SensorsUnleashed/relayboard/output/Drill file generation.png

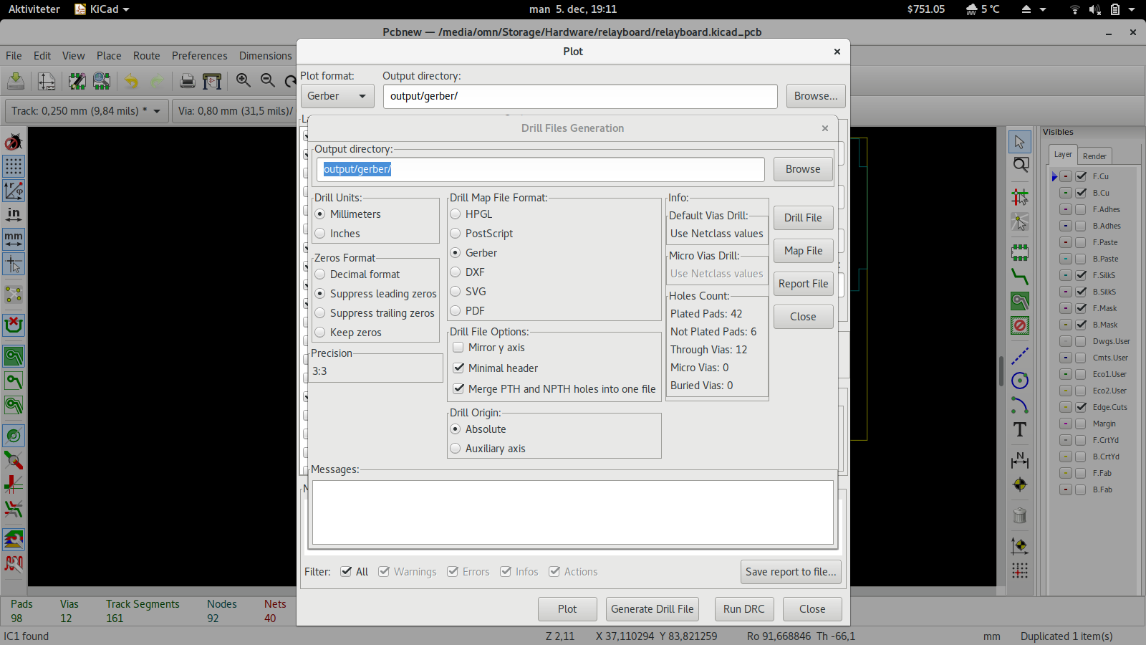
output/Drill file generation.png
