SensorsUnleashed/relayboard/output/Gerber generation.png

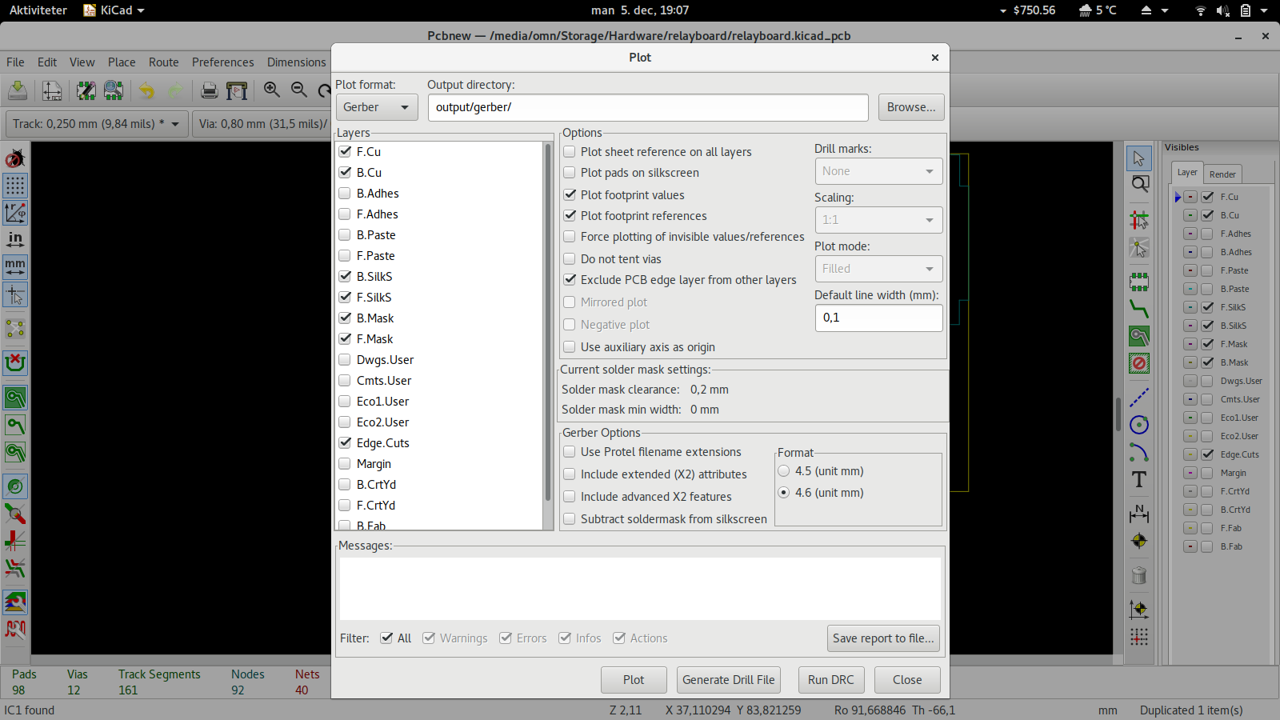
output/Gerber generation.png
