SensorsUnleashed/relayboard/output/schematic.pdf

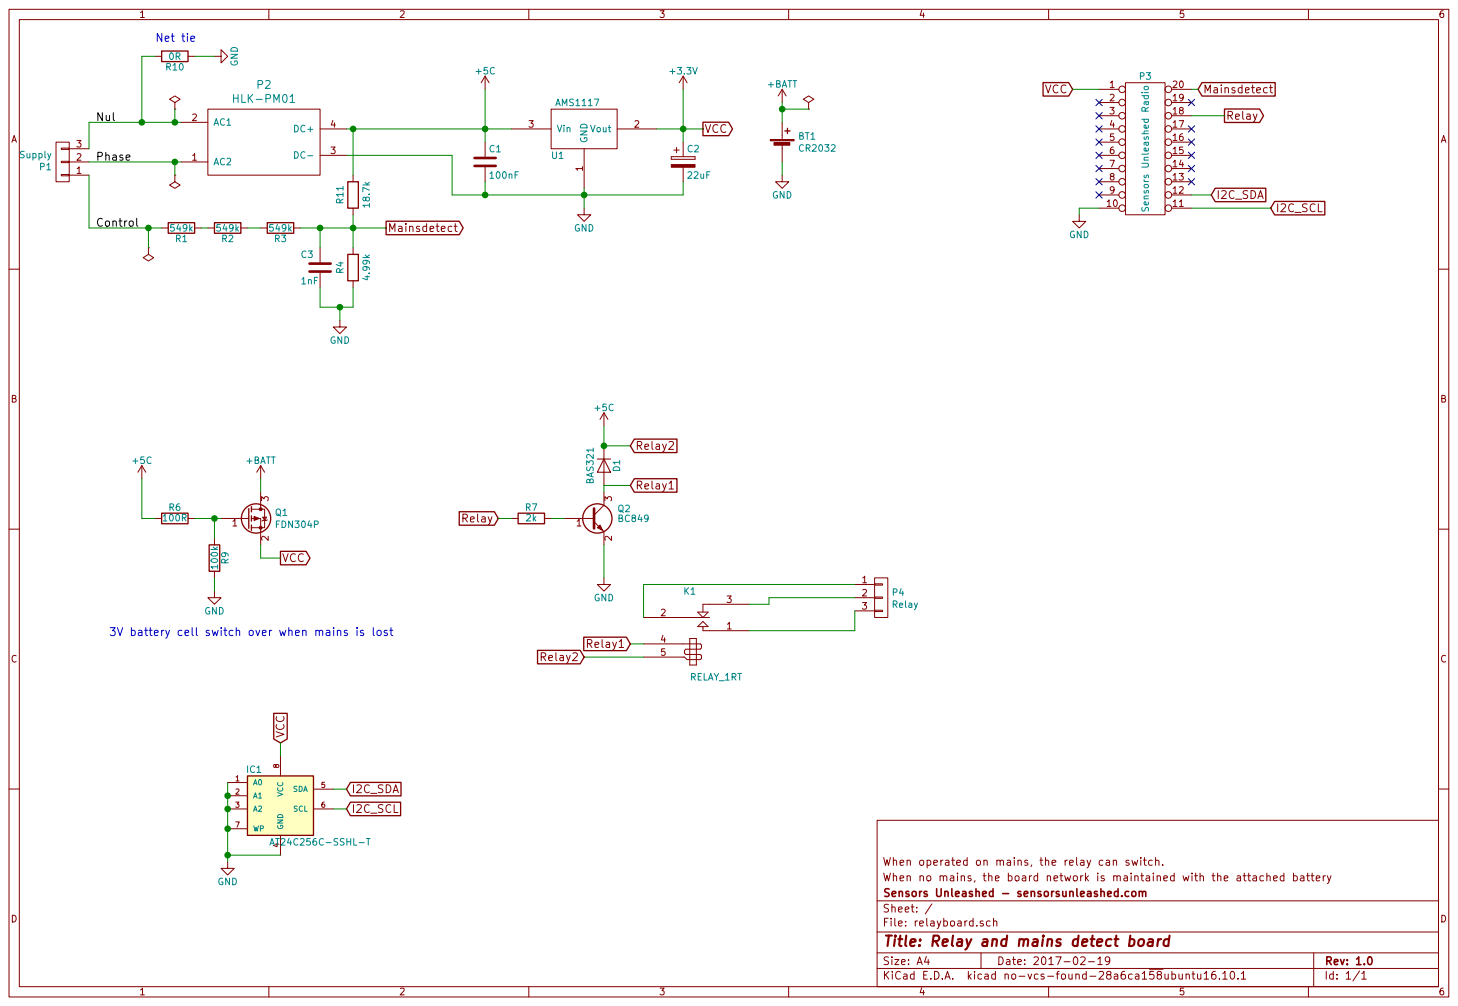
[picture p11: page 1]

3V battery cell switch over when mains is lost

4 SDA 5 SCL 6 WP 7 VCC

When operated on mains, the relay can switch.
File: relayboard.sch Sheet: / Sensors Unleashed - sensorsunleashed.com When no mains, the board network is maintained with the attached battery

Id: 1/1 Title: Relay and mains detect board
