SensorsUnleashed/relayboard/relayboard.kicad_pcb

## KiCad design relayboard.kicad_pcb (2017-03-07)

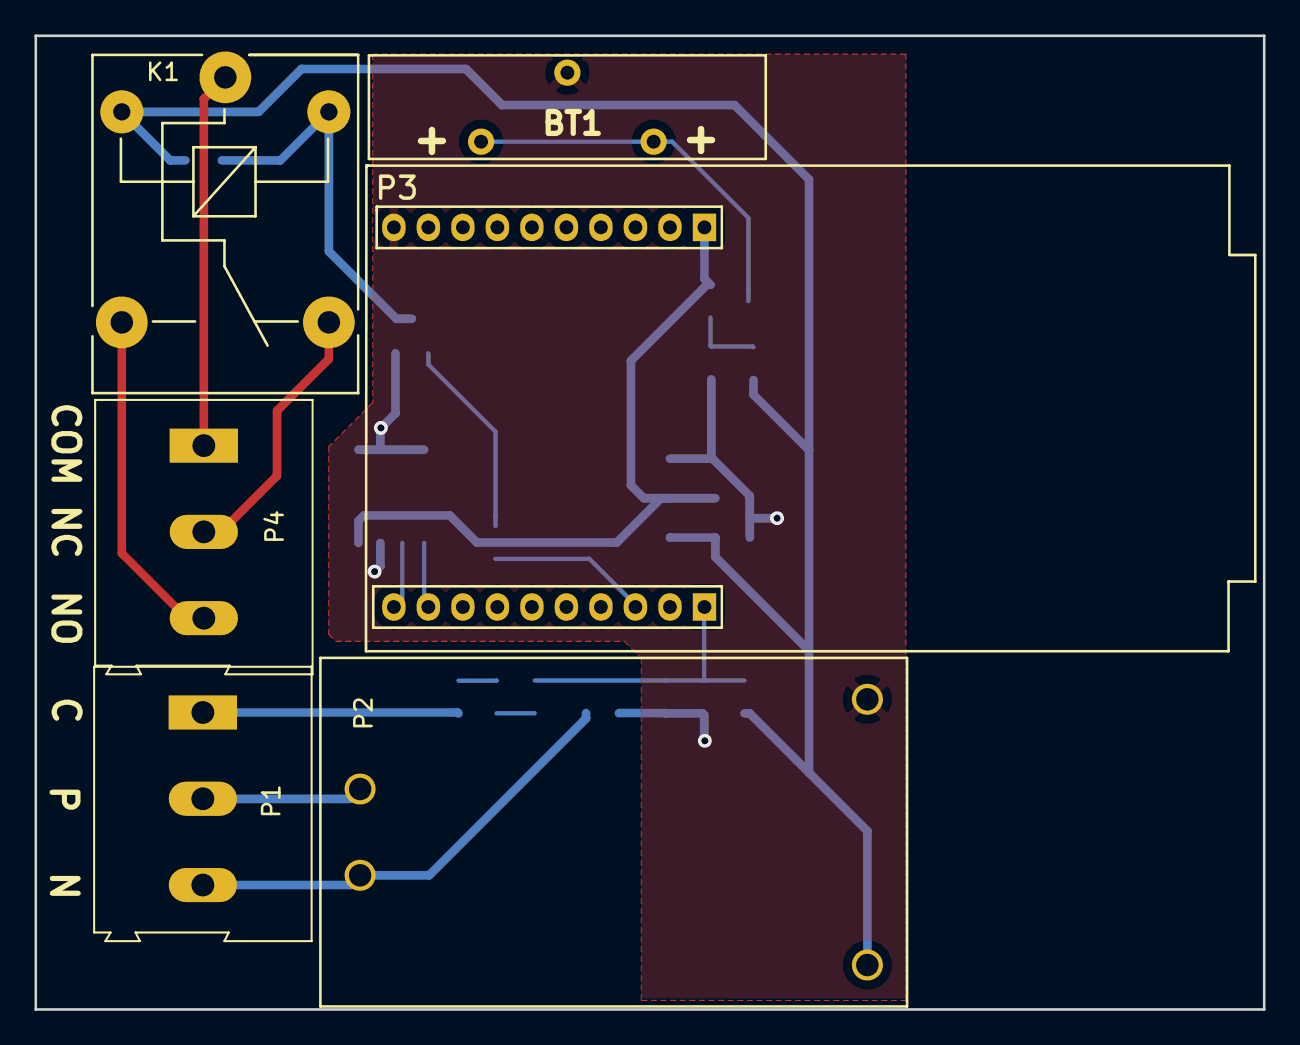
[picture p12: board relayboard.kicad_pcb from above]

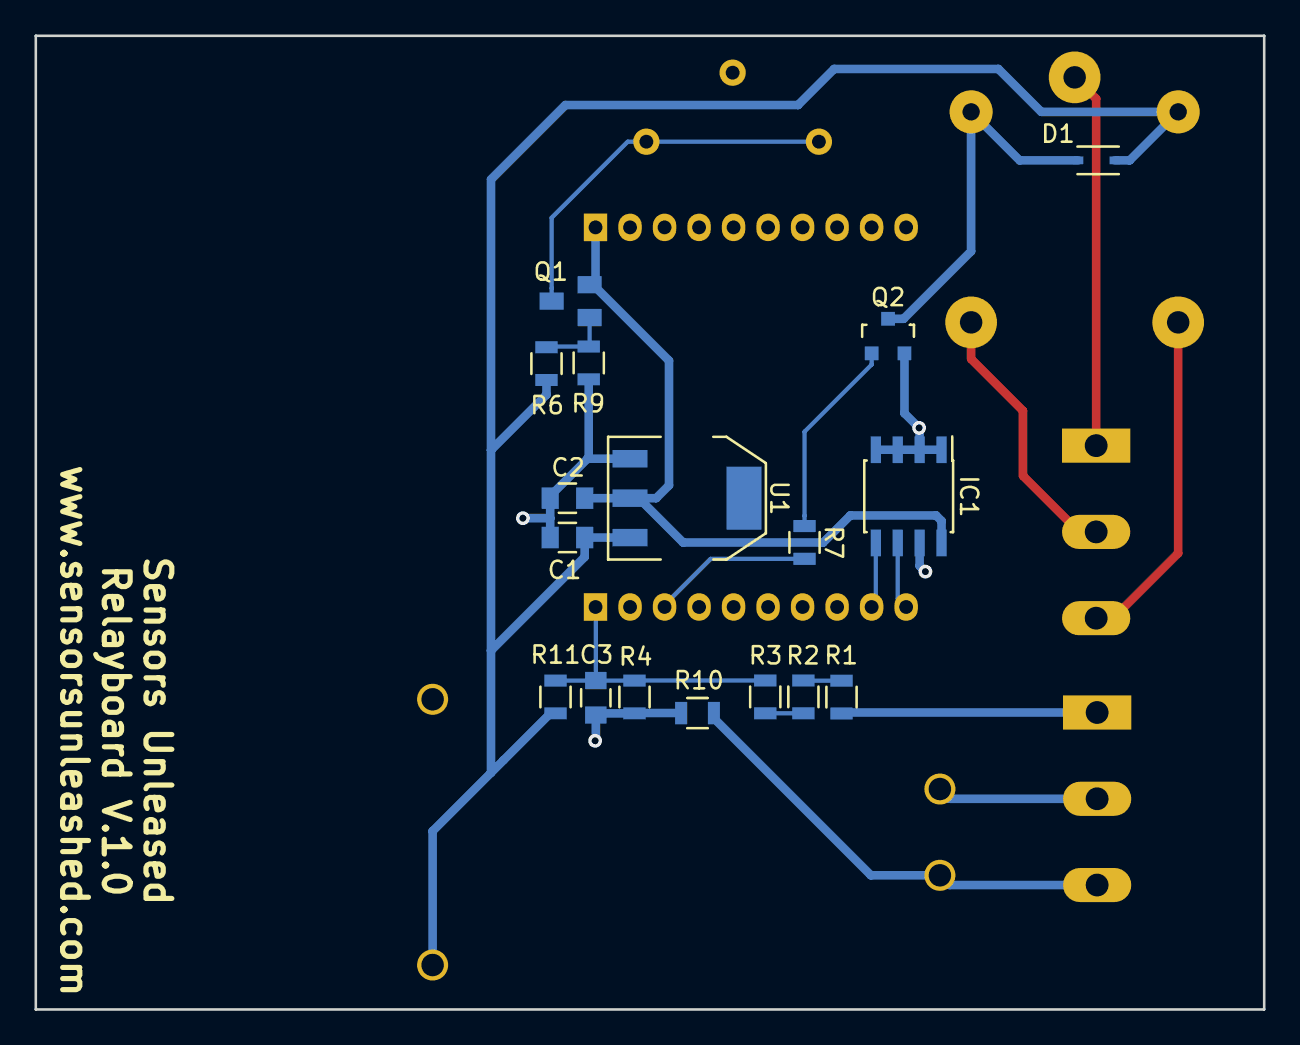
[picture p13: board relayboard.kicad_pcb from below]

Board: 2 copper layers, 71.2 x 56.4 mm, 23 parts (17 on the bottom side), 19 nets.

Parts:
BT1: CR2032; BATT_CR2032_VERT
C1: 100nF; C_0805
C2: 22uF; C_0805
C3: 1nF; C_0805
D1: BAS321; SOD-323
IC1: AT24C256C-SSHL-T; SOIC-8_3.9x4.9mm_Pitch1.27mm
K1: RELAY_1RT; Relay_SRD_XVDC-SL-C_Series
P1: Supply; AK300-3
P2: HLK-PM01
P3: Sensors Unleashed Radio; zb3219PA_radio
P4: Relay; AK300-3
Q1: FDN304P; SSOT-3
Q2: BC849; SOT-23
R1, R2, R3: 330k; R_0805
R4: 6040R; R_0805
R6: 100R; R_0805
R7: 2k; R_0805
R9: 100k; R_0805
R10: 0R; R_0805
R11: 12835R; R_0805
U1: AMS1117; SOT-223

Connections:
+BATT: BT1.1, Q1.3
/Control: P1.1, R1.2
/Nul: P1.3, P2.2, R10.2
/Phase: P1.2, P2.1
GND: BT1.2, C1.2, C2.2, C3.2, IC1.1, IC1.2, IC1.3, IC1.4, IC1.7, P2.3, P3.10, Q2.2, R4.2, R9.2, R10.1, U1.1
I2C_SCL: IC1.6, P3.11
I2C_SDA: IC1.5, P3.12
Mainsdetect: C3.1, P3.20, R3.1, R4.1, R11.2
unnamed: K1.1, P4.3
unnamed: K1.2, P4.1
unnamed: K1.3, P4.2
unnamed: Q1.1, R6.2, R9.1
unnamed: Q2.1, R7.2
unnamed: R1.1, R2.2
unnamed: R2.1, R3.2
Relay: P3.18, R7.1
Relay1: D1.2, K1.4, Q2.3
Relay2: C1.1, D1.1, K1.5, P2.4, R6.1, R11.1, U1.3
VCC: C2.1, IC1.8, P3.1, Q1.2, U1.2
