SensorsUnleashed/relayboard/(commit log)

2017-03-07 First prototype
    [bom.csv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]
2017-03-14 Recalculated the mains detect circuit
    [relayboard.sch]
2017-03-14 Added schematic as pdf
